McLehotsky/poit_peltier_project/documentation/Obrazky/volaniePoziadavkyWEBstranky.png

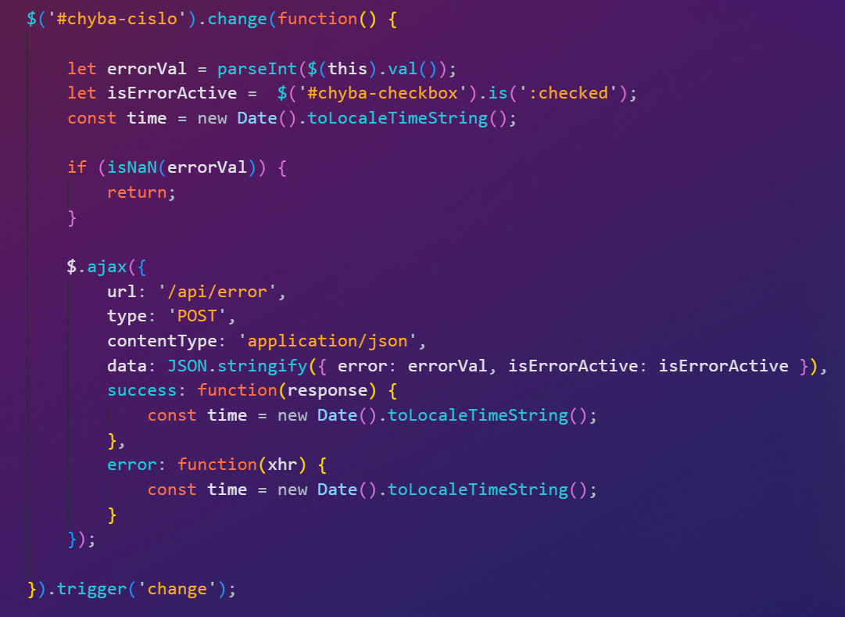
documentation/Obrazky/volaniePoziadavkyWEBstranky.png
