McLehotsky/poit_peltier_project/documentation/Obrazky/dashboard1.png

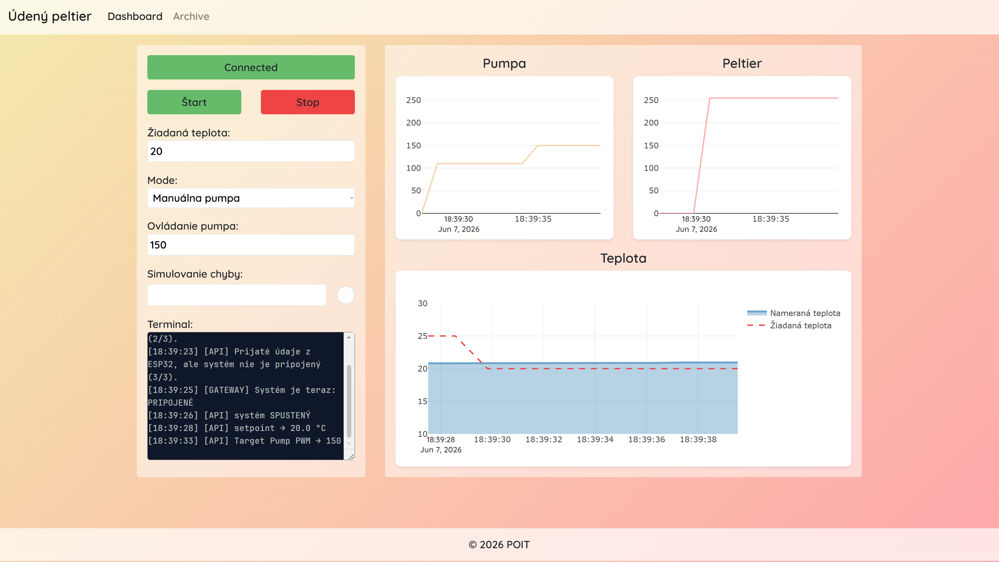
documentation/Obrazky/dashboard1.png
