McLehotsky/poit_peltier_project/documentation/Kapitoly/Kapitola5.tex

% !TEX root = ../main.tex

\section{Softvérová časť}

Softvérová časť projektu zabezpečuje prepojenie medzi hardvérovým modelom, 
lokálnym webovým rozhraním, databázou a cloudovou platformou ThingsBoard. 
Hlavnou úlohou softvéru je prijímať dáta z mikrokontroléra ESP32, 
spracovať aktuálny stav systému, zobraziť namerané hodnoty v reálnom čase, 
ukladať historické merania a umožniť lokálne aj vzdialené ovládanie systému.

Základný tok dát je navrhnutý tak, že ESP32 periodicky odosiela aktuálne hodnoty na 
Flask server. Server prijaté dáta spracuje, odošle ich do lokálneho webového dashboardu 
pomocou WebSocket komunikácie, pri aktívnom meraní ich uloží do dočasného buffra 
a zároveň publikuje telemetriu do platformy ThingsBoard. Po zastavení merania 
sa celá meracia sekvencia uloží do MySQL databázy a do záložného JSON súboru.

\begin{figure}[H]
    \centering
    \safeimage{obrazky/tok_dat.png}{0.90\textwidth}{Diagram toku dát softvérovej časti systému}
    \label{fig:tok_dat_softver}
\end{figure}

\subsection{Architektúra softvérového riešenia}

Softvérové riešenie je sústredené okolo Flask servera, ktorý prepája ESP32, webové rozhranie, databázu a platformu ThingsBoard. ESP32 zabezpečuje meranie a výkonové riadenie, zatiaľ čo server spracúva prijaté dáta, uchováva aktuálny stav systému a poskytuje rozhrania pre lokálne aj vzdialené ovládanie.

Hlavné softvérové časti sú:

\begin{itemize}
    \item \textbf{ESP32 firmvér} -- odosielanie nameraných hodnôt a prijímanie riadiacich parametrov,
    \item \textbf{Flask server} -- REST API, WebSocket komunikácia, stav systému a ukladanie dát,
    \item \textbf{webové rozhranie} -- realtime grafy, ovládacie prvky a archív meraní,
    \item \textbf{ThingsBoard integrácia} -- MQTT telemetria a vybrané vzdialené príkazy.
\end{itemize}

\subsection{Komunikácia ESP32 so serverom}

Mikrokontrolér ESP32 odosiela namerané údaje na Flask server pomocou HTTP požiadavky 
na endpoint \path{/api/update}. Odosielaná správa obsahuje aktuálnu teplotu kvapaliny, 
PWM hodnotu pumpy a PWM hodnotu Peltierovho článku.

\begin{lstlisting}[language=json, caption={Príklad dát odosielaných z ESP32 na server}]
{
  "temperature": 24.5,
  "pump_pwm": 150,
  "tec_pwm": 120
}
\end{lstlisting}

Server po prijatí dát aktualizuje svoj interný stav a odošle ESP32 spätnú odpoveď. 
Tá obsahuje napríklad informáciu o tom, či je systém pripojený, či beží meranie, 
aký režim riadenia je zvolený, aké sú cieľové PWM hodnoty a aká je nastavená požadovaná teplota.

\begin{lstlisting}[language=json, caption={Príklad odpovede servera pre ESP32}]
{
  "status": "ok",
  "connected": true,
  "running": true,
  "mode": 1,
  "target_pump": 150,
  "target_tec": 120,
  "setpoint": 25.0
}
\end{lstlisting}

Dôležitým prvkom je stav \path{connected}. Ak server vráti hodnotu \path{connected=false}, 
hardvér ostáva v bezpečnom stave a výkonové prvky nemusia byť aktivované. Tým sa zabraňuje 
nechcenému spusteniu Peltierovho článku alebo pumpy.

\subsection{Backend Flask server a REST API}

Flask server tvorí centrálny bod softvérovej časti. Prijíma dáta z ESP32, uchováva 
aktuálny stav systému, spracúva príkazy z webového rozhrania, komunikuje s ThingsBoardom a 
zabezpečuje ukladanie meraní. Aktuálne hodnoty sú uložené v stavovej premennej 
\path{system_state}, ktorá obsahuje napríklad teplotu, PWM hodnoty, setpoint, režim riadenia, 
stav merania a buffer aktuálnej session.

Pre komunikáciu sú vytvorené REST API endpointy uvedené v tabuľke \ref{tab:rest_api_endpointy}.

{\small
\begin{longtable}{|>{\RaggedRight\arraybackslash}p{0.33\textwidth}|>{\centering\arraybackslash}p{0.12\textwidth}|>{\RaggedRight\arraybackslash}p{0.45\textwidth}|}
\hline
\textbf{Endpoint} & \textbf{Metóda} & \textbf{Úloha} \\
\hline
\path{/api/update} & POST & Príjem aktuálnych dát z ESP32. \\
\hline
\path{/api/connect} & POST & Logické pripojenie alebo odpojenie systému. \\
\hline
\path{/api/start} & POST & Spustenie merania alebo regulácie. \\
\hline
\path{/api/stop} & POST & Zastavenie systému a uloženie aktuálnej session. \\
\hline
\path{/api/setpoint} & POST & Nastavenie požadovanej teploty. \\
\hline
\path{/api/mode} & POST & Nastavenie režimu riadenia systému. \\
\hline
\path{/api/pwm_pump} & POST & Nastavenie cieľovej PWM hodnoty pumpy. \\
\hline
\path{/api/pwm_tec} & POST & Nastavenie cieľovej PWM hodnoty Peltierovho článku. \\
\hline
\path{/api/error} & POST & Nastavenie simulovanej chyby alebo poruchového vstupu. \\
\hline
\path{/api/read_db/<id>} & GET & Čítanie historického záznamu z databázy. \\
\hline
\path{/api/read_log/<id>} & GET & Čítanie historického záznamu zo súboru JSON. \\
\hline
\caption{Prehľad hlavných REST API endpointov}
\label{tab:rest_api_endpointy}
\end{longtable}
}

Endpoint \path{/api/update} je hlavný vstupný bod pre dáta z hardvéru. Endpointy \path{/api/start} a \path{/api/stop} riadia začiatok a koniec merania. Endpointy pre setpoint, režim riadenia a PWM hodnoty slúžia na zmenu riadiacich parametrov systému.

Na strane Flask servera sú jednotlivé endpointy definované pomocou dekorátora \path{@app.route}. 
Každý endpoint má určenú URL adresu a povolenú HTTP metódu. Po prijatí požiadavky server upraví 
príslušnú hodnotu v premennej \path{system_state}, prípadne vykoná doplnkovú akciu, napríklad 
uloženie merania alebo zápis správy do terminálu. Príklad definície endpointov pre zastavenie 
systému a nastavenie PWM hodnôt pumpy a Peltierovho článku je uvedený na obrázku 
\ref{fig:def_endpoint}.

\begin{figure}[H]
    \centering
    \safeimage{obrazky/defEndpoint.png}{0.95\textwidth}{Príklad definície REST API endpointov vo Flask serveri}
    \label{fig:def_endpoint}
\end{figure}

\subsection{Webové rozhranie a realtime prenos dát}

Lokálne webové rozhranie slúži na sledovanie aktuálneho stavu systému a na zadávanie 
riadiacich príkazov. Frontend je vytvorený pomocou HTML, CSS a JavaScriptu. 
Grafy sú vykresľované pomocou knižnice Plotly.

Realtime prenos dát medzi serverom a webovým rozhraním je realizovaný pomocou WebSocket 
komunikácie cez Flask-SocketIO. Po prijatí nových dát zo zariadenia server odošle udalosť 
\path{new_data}, ktorú frontend použije na aktualizáciu grafov.

Webové rozhranie zobrazuje:

\begin{itemize}
    \item aktuálnu teplotu kvapaliny,
    \item požadovanú teplotu,
    \item PWM hodnotu pumpy,
    \item PWM hodnotu Peltierovho článku,
    \item aktuálny stav systému a režim riadenia.
\end{itemize}

Používateľ môže cez webové rozhranie systém pripojiť, spustiť alebo zastaviť meranie, 
nastaviť požadovanú teplotu, zvoliť regulačný mód a manuálne nastaviť PWM hodnoty pumpy a 
Peltierovho článku. Manuálne nastavenie oboch PWM hodnôt je využité aj v samostatnom 
manuálnom režime, ktorý slúži na priame ovládanie pumpy a Peltierovho článku bez automatického 
regulačného zásahu. Súčasťou webovej aplikácie je aj archívna stránka, ktorá umožňuje 
zobrazenie historických meraní z databázy alebo zo súboru JSON.

Príkazy z webového rozhrania sú na server odosielané pomocou asynchrónnych HTTP požiadaviek. 
Na strane JavaScriptu sa pri zmene hodnoty vo formulári alebo po stlačení tlačidla vytvorí 
požiadavka na príslušný endpoint. Dáta sú odoslané vo formáte JSON, pričom server následne 
aktualizuje svoj interný stav a pri ďalšej komunikácii odošle nové hodnoty do ESP32. Príklad 
volania požiadavky z webového rozhrania pre nastavenie simulovanej chyby je uvedený na obrázku 
\ref{fig:volanie_poziadavky_web}.

\begin{figure}[H]
    \centering
    \safeimage{obrazky/volaniePoziadavkyWEBstranky.png}{0.95\textwidth}{Príklad volania požiadavky z webového rozhrania}
    \label{fig:volanie_poziadavky_web}
\end{figure}

Návrh lokálneho webového rozhrania bol pred samotnou implementáciou pripravený vo Figme. 
Cieľom návrhu bolo rozdeliť aplikáciu na dve hlavné časti -- aktuálny dashboard a archív 
meraní. Dashboard bol navrhnutý ako hlavná obrazovka pre ovládanie systému, zobrazovanie 
aktuálnych grafov a sledovanie diagnostických informácií. Archívna časť bola navrhnutá 
na výber zdroja dát a zobrazenie historických záznamov z databázy alebo zo súboru JSON.

\begin{figure}[H]
    \centering
    \safeimage{obrazky/figma1.jpg}{0.90\textwidth}{Návrh hlavného dashboardu vo Figme}
    \label{fig:figma_dashboard}
\end{figure}

\begin{figure}[H]
    \centering
    \safeimage{obrazky/figma2.jpg}{0.90\textwidth}{Návrh archívnej obrazovky vo Figme}
    \label{fig:figma_archiv}
\end{figure}

Pri implementácii bol návrh upravený do webovej aplikácie zobrazenej v prehliadači. 
Hlavný dashboard obsahuje tlačidlá na pripojenie systému, spustenie a zastavenie merania, 
nastavenie požadovanej teploty, výber režimu riadenia, manuálne zadanie PWM hodnoty pumpy 
a diagnostický terminál. Pravá časť obrazovky slúži na zobrazenie grafov PWM pumpy, 
PWM Peltierovho článku a aktuálnej teploty kvapaliny.

\begin{figure}[H]
    \centering
    \safeimage{obrazky/dashboard1.png}{0.95\textwidth}{Implementované lokálne webové rozhranie -- dashboard}
    \label{fig:web_dashboard}
\end{figure}

Archívna obrazovka umožňuje zvoliť zdroj dát, zadať index záznamu a následne zobraziť 
uložené historické priebehy. Zobrazované sú samostatné grafy pre PWM pumpy, PWM Peltierovho 
článku a teplotu. Takéto rozdelenie uľahčuje spätné vyhodnotenie merania a kontrolu priebehu 
akčných zásahov.

\begin{figure}[H]
    \centering
    \safeimage{obrazky/dashboard2.png}{0.95\textwidth}{Implementované lokálne webové rozhranie -- archív meraní}
    \label{fig:web_archiv}
\end{figure}

\subsection{Dátová vrstva -- MySQL a JSON}

Dátová vrstva je navrhnutá ako dvojúrovňové ukladanie nameraných údajov. 
Počas aktívneho merania sa dáta ukladajú do dočasného buffra \path{session_buffer}. 
Dátové body sa do buffra pridávajú iba vtedy, keď je systém v stave \path{running=True}. 
Tým sa zabraňuje ukladaniu zbytočných údajov v pohotovostnom režime.

Každý dátový bod obsahuje poradové číslo vzorky, časovú značku, teplotu, 
PWM hodnotu pumpy, PWM hodnotu Peltierovho článku, požadovanú teplotu a aktuálny režim riadenia.

Po zastavení merania sa celá session uloží naraz do dvoch úložísk:

\begin{itemize}
    \item do MySQL databázy \path{ml_poit}, tabuľka \path{graph},
    \item do lokálneho súboru \path{data_log.json}.
\end{itemize}

Databáza slúži ako hlavné úložisko historických meraní. JSON súbor slúži ako 
jednoduchá záloha a umožňuje čítanie dát aj bez databázového servera. 
Po úspešnom uložení sa buffer vyčistí a systém je pripravený na ďalšie meranie.

Ukladanie do databázy bolo overené pomocou nástroja phpMyAdmin. V databáze sa nachádza 
tabuľka \path{graph}, v ktorej je každá meracia session uložená ako samostatný záznam. 
Stĺpec \path{hodnoty} obsahuje priebeh merania vo forme JSON reťazca a stĺpec 
\path{created_at} uchováva čas vytvorenia záznamu.

\begin{figure}[H]
    \centering
    \safeimage{obrazky/Databaza.png}{0.95\textwidth}{Uložené meracie záznamy v MySQL databáze zobrazené cez phpMyAdmin}
    \label{fig:databaza_mysql}
\end{figure}

Paralelne s databázovým zápisom sa merania ukladajú aj do súboru \path{data_log.json}. 
Každý riadok súboru predstavuje jednu meraciu session a obsahuje postupnosť dátových bodov. 
Dátový bod obsahuje poradové číslo vzorky, časovú značku, nameranú teplotu, PWM hodnotu pumpy, 
PWM hodnotu Peltierovho článku, požadovanú teplotu a aktuálny režim systému.

\begin{figure}[H]
    \centering
    \safeimage{obrazky/JSON.png}{0.95\textwidth}{Záložné ukladanie meraní do súboru data\_log.json}
    \label{fig:json_log}
\end{figure}

\subsection{ThingsBoard integrácia}

Pre vzdialený monitoring a manažment systému bola použitá platforma ThingsBoard. 
Flask server komunikuje s ThingsBoardom pomocou MQTT protokolu na porte 
\path{1883} s autentifikáciou pomocou prístupového tokenu zariadenia. 

MQTT klient beží asynchrónne v separátnom vlákne (\texttt{loop\_start()}), čím neblokuje hlavnú Flask aplikáciu. Konfigurácia pripojenia je definovaná nasledovne:

\begin{verbatim}
TB_HOST  = "thingsboard.cloud"
TB_PORT  = 1883
TB_TOKEN = <device_access_token>
\end{verbatim}

Po prijatí dát z ESP32 server publikuje telemetriu na topic 
\path{v1/devices/me/telemetry}.

Pripojenie k ThingsBoardu je v backendovej časti aplikácie definované pomocou parametrov 
\path{TB_HOST}, \path{TB_PORT} a \path{TB_TOKEN}. Parameter \path{TB_HOST} určuje adresu 
ThingsBoard servera, parameter \path{TB_PORT} určuje port MQTT komunikácie a parameter 
\path{TB_TOKEN} predstavuje prístupový token zariadenia vytvoreného v ThingsBoarde. 
V projekte bola použitá cloudová inštancia \path{thingsboard.cloud} a MQTT port \path{1883}.

\begin{lstlisting}[caption={Základné nastavenie pripojenia k ThingsBoardu}]
TB_HOST = "thingsboard.cloud"
TB_PORT = 1883
TB_TOKEN = "<device_access_token>"
\end{lstlisting}

MQTT klient beží asynchrónne v samostatnom vlákne, aby neblokoval hlavnú Flask aplikáciu. 
Server tak môže súčasne prijímať dáta z ESP32, obsluhovať lokálne webové rozhranie a odosielať 
telemetriu do cloudovej platformy.

Do ThingsBoardu sa odosielajú hlavné veličiny uvedené v tabuľke \ref{tab:thingsboard_telemetria}.

{\small
\begin{longtable}{|>{\RaggedRight\arraybackslash}p{0.26\textwidth}|>{\RaggedRight\arraybackslash}p{0.48\textwidth}|>{\RaggedRight\arraybackslash}p{0.16\textwidth}|}
\hline
\textbf{Kľúč} & \textbf{Popis} & \textbf{Jednotka / rozsah} \\
\hline
\path{temperature} & Nameraná teplota kvapaliny. & $^\circ$C \\
\hline
\path{setpoint} & Požadovaná teplota. & $^\circ$C \\
\hline
\path{error} & Regulačná odchýlka. & $^\circ$C \\
\hline
\path{pump_pwm} & PWM hodnota pumpy. & 0--255 \\
\hline
\path{tec_pwm} & PWM hodnota Peltierovho článku. & 0--255 \\
\hline
\path{mode} & Aktívny režim systému. & 1 / 2 / 3 / 4 \\
\hline
\path{running} & Stav regulácie. & bool \\
\hline
\caption{Telemetrické veličiny odosielané do ThingsBoardu}
\label{tab:thingsboard_telemetria}
\end{longtable}
}

Okrem číselných hodnôt sa do ThingsBoardu odosiela aj textový atribút \path{terminal}, 
ktorý zobrazuje stručný diagnostický stav systému. 

Dashboard v ThingsBoarde je rozdelený na dva stavy. 

V prostredí ThingsBoard bol vytvorený dashboard \textit{Peltier Control System}. Dashboard je 
rozdelený na dva hlavné stavy: \textit{Default} a \textit{Archív}. Stav \textit{Default} slúži 
na sledovanie a ovládanie systému v reálnom čase. Obsahuje grafy teploty, PWM pumpy a PWM 
Peltierovho článku, ovládacie tlačidlá, prepínanie módov, vstupy pre manuálne PWM hodnoty 
a diagnostické widgety. Stav \textit{Archív} slúži na zobrazenie historických údajov za posledných 
24 hodín.

Vizualizačné widgety v stave \textit{Default} sú naviazané na telemetrické kľúče odosielané 
z Flask servera. Graf teploty zobrazuje hodnoty \path{temperature} a \path{setpoint} 
v časovom okne 300~s. Graf pumpy zobrazuje hodnotu \path{pump_pwm} v časovom 
okne 60~s a graf Peltierovho článku zobrazuje hodnotu \path{tec_pwm} taktiež v 
časovom okne 60~s. Aktualizácia grafov je nastavená na 1~s.

{\small
\begin{longtable}{|>{\RaggedRight\arraybackslash}p{0.30\textwidth}|>{\RaggedRight\arraybackslash}p{0.28\textwidth}|>{\RaggedRight\arraybackslash}p{0.18\textwidth}|>{\RaggedRight\arraybackslash}p{0.14\textwidth}|}
\hline
\textbf{Widget} & \textbf{Sledovaná veličina} & \textbf{Časové okno} & \textbf{Aktualizácia} \\
\hline
Teplota [C$^\circ$] (\path{w_teplota}) & \path{temperature}, \path{setpoint} & 300~s & 1~s \\
\hline
Pumpa (\path{w_pumpa}) & \path{pump_pwm} & 60~s & 1~s \\
\hline
PET (\path{w_pet}) & \path{tec_pwm} & 60~s & 1~s \\
\hline
\caption{Vizualizačné widgety v stave Default}
\label{tab:tb_default_widgety}
\end{longtable}
}

Ovládacie tlačidlá \textit{Connect}, \textit{Start} a \textit{Stop} odosielajú RPC príkazy, ktoré 
Flask server spracuje a premietne do aktuálneho stavu systému. Tlačidlá \textit{Mod 1}, 
\textit{Mod 2}, \textit{Mod 3} a \textit{Mod 4} nastavujú režim systému zápisom zdieľaného atribútu 
\path{control_mode}. Prvé tri módy predstavujú regulačné režimy podľa zadania, pričom doplnený 
štvrtý mód predstavuje manuálne riadenie pumpy aj Peltierovho článku.

{\small
\begin{longtable}{|>{\RaggedRight\arraybackslash}p{0.30\textwidth}|>{\RaggedRight\arraybackslash}p{0.35\textwidth}|>{\centering\arraybackslash}p{0.20\textwidth}|}
\hline
\textbf{Widget} & \textbf{Zdieľaný atribút / metóda} & \textbf{Hodnota} \\
\hline
Connect (\path{w_connect}) & \path{setConnected} & \path{true} \\
\hline
Start (\path{w_start}) & \path{setRunning} & \path{true} \\
\hline
Stop (\path{w_stop}) & \path{setRunning} & \path{false} \\
\hline
Mod 1 (\path{w_mod1}) & \path{control_mode} & 1 \\
\hline
Mod 2 (\path{w_mod2}) & \path{control_mode} & 2 \\
\hline
Mod 3 (\path{w_mod3}) & \path{control_mode} & 3 \\
\hline
Mod 4 (\path{w_mod4}) & \path{control_mode} & 4 \\
\hline
\caption{Ovládacie widgety v ThingsBoard dashboarde}
\label{tab:tb_ovladacie_widgety}
\end{longtable}
}

Vstupné polia pre manuálne PWM hodnoty umožňujú nastaviť výkon pumpy a Peltierovho článku. 
Hodnoty sa zapisujú do zdieľaných atribútov zariadenia a Flask server ich prijíma cez MQTT komunikáciu.

{\small
\begin{longtable}{|>{\RaggedRight\arraybackslash}p{0.34\textwidth}|>{\RaggedRight\arraybackslash}p{0.34\textwidth}|>{\RaggedRight\arraybackslash}p{0.12\textwidth}|>{\RaggedRight\arraybackslash}p{0.12\textwidth}|}
\hline
\textbf{Widget} & \textbf{Zdieľaný atribút} & \textbf{Typ} & \textbf{Rozsah} \\
\hline
Ovládanie: Pump PWM (\path{w_pump_ctrl}) & \path{target_pump_pwm} & integer & 0--255 \\
\hline
Ovládanie: TEC PWM (\path{w_tec_ctrl}) & \path{target_tec_pwm} & integer & 0--255 \\
\hline
\caption{Manuálne nastavenie PWM hodnôt cez ThingsBoard}
\label{tab:tb_pwm_vstupy}
\end{longtable}
}

Diagnostický widget \textit{Error} (\path{w_error}) zobrazuje aktuálnu regulačnú odchýlku ako 
hodnotu z telemetrie. Widget \textit{Terminal} (\path{w_terminal}) zobrazuje diagnostický reťazec 
\path{terminal}, ktorý je serverom aktualizovaný pri každom odoslaní telemetrie. Diagnostický 
reťazec má formát:

\begin{center}
\texttt{T=XX.X$^\circ$C\ | \ Err=X.XX\ | \ RUN/STOP\ | \ Mode=X}
\end{center}

Stav \textit{Archív} obsahuje historické grafy pre teplotu, PWM pumpy a PWM Peltierovho článku. 
Grafy pracujú s časovým oknom posledných 24 hodín.

{\small
\begin{longtable}{|>{\RaggedRight\arraybackslash}p{0.34\textwidth}|>{\RaggedRight\arraybackslash}p{0.34\textwidth}|>{\RaggedRight\arraybackslash}p{0.22\textwidth}|}
\hline
\textbf{Widget} & \textbf{Sledovaná veličina} & \textbf{Časové okno} \\
\hline
Teplota [C$^\circ$] (\path{a_teplota}) & \path{temperature}, \path{setpoint} & posledných 24 hodín \\
\hline
Pumpa (\path{a_pumpa}) & \path{pump_pwm} & posledných 24 hodín \\
\hline
PET (\path{a_pet}) & \path{tec_pwm} & posledných 24 hodín \\
\hline
\caption{Widgety v stave Archív}
\label{tab:tb_archiv_widgety}
\end{longtable}
}

\begin{figure}[H]
    \centering
    \safeimage{obrazky/thingsboard_default1.0.png}{0.95\textwidth}{ThingsBoard dashboard v stave Default}
    \label{fig:thingsboard_default}
\end{figure}

Stav \textit{Archív} slúži na zobrazenie historických dát s časovým oknom 1 deň.

\begin{table}[H]
\centering
\begin{tabular}{lll}
\toprule
\textbf{Widget (ID)} & \textbf{Sledovaná veličina} & \textbf{Časové okno} \\
\midrule
Teplota [C°] (\texttt{a\_teplota}) & \texttt{temperature}, \texttt{setpoint} & Posledných 24 hodín \\
Pumpa (\texttt{a\_pumpa})          & \texttt{pump\_pwm}                     & Posledných 24 hodín \\
PET (\texttt{a\_pet})              & \texttt{tec\_pwm}                      & Posledných 24 hodín \\
\bottomrule
\end{tabular}
\caption{Archívne widgety}
\end{table}

Stránka archívu umožňuje prezerať uložené záznamy meraní. 
Widget \texttt{a\_filter} v ThingsBoard dashboarde obsahuje tri ovládacie prvky:

TU DOPLNIT ESTE!!!!!!

\begin{figure}[H]
    \centering
    \safeimage{obrazky/thingsboard_archiv1.0.png}{0.95\textwidth}{ThingsBoard dashboard v stave Archív}
    \label{fig:thingsboard_archiv}
\end{figure}

\subsection{Obojsmerná komunikácia s ThingsBoardom}

Systém neodosiela do ThingsBoardu iba telemetriu, ale zároveň prijíma aj vybrané riadiace 
príkazy. Použité sú dva mechanizmy. Prvým sú RPC príkazy cez topic 
\path{v1/devices/me/rpc/request/+}, ktoré sa používajú hlavne pre tlačidlá 
\textit{Connect}, \textit{Start} a \textit{Stop}. Druhým mechanizmom sú zdieľané atribúty cez 
topic \path{v1/devices/me/attributes}.

Po prijatí RPC príkazu server aktualizuje svoj lokálny stav a odošle späť potvrdzujúcu odpoveď.

\begin{lstlisting}[caption={Príklad odpovede na RPC príkaz z ThingsBoardu}]
mqtt_client.publish(
    topic = "v1/devices/me/rpc/response/{request_id}",
    payload = json.dumps({"status": "ok"})
)
\end{lstlisting}

Cez zdieľané atribúty sa prenášajú najmä:

\begin{itemize}
    \item \path{control_mode} -- nastavenie režimu systému,
    \item \path{target_pump_pwm} -- cieľová PWM hodnota pumpy,
    \item \path{target_tec_pwm} -- cieľová PWM hodnota Peltierovho článku.
\end{itemize}

Po každom pripojení si server môže aktívne vyžiadať aktuálne hodnoty zdieľaných atribútov, aby 
sa predišlo desynchronizácii po reštarte aplikácie.

\begin{lstlisting}[caption={Vyžiadanie aktuálnych zdieľaných atribútov}]
client.publish(
    "v1/devices/me/attributes/request/1",
    json.dumps({"sharedKeys": "control_mode,target_pump_pwm,target_tec_pwm"})
)
\end{lstlisting}

Po prijatí zmeny z ThingsBoardu Flask server aktualizuje svoj interný stav a pri 
najbližšej komunikácii odošle nové hodnoty do ESP32. Zmeny môžu byť zároveň odoslané 
aj do lokálneho webového dashboardu pomocou WebSocket udalosti \path{status_update}.

\subsection{Režimy riadenia systému}

Systém podporuje tri regulačné módy požadované zadaním, ktoré je možné prepínať z webového 
rozhrania alebo z ThingsBoard dashboardu. Okrem týchto režimov bol doplnený aj štvrtý 
manuálny režim, ktorý slúži na priame nastavenie PWM hodnoty pumpy a Peltierovho článku.

\begin{itemize}
    \item \textbf{Mód 1} -- regulácia pomocou Peltierovho článku pri konštantnom alebo manuálne nastavenom výkone pumpy,
    \item \textbf{Mód 2} -- regulácia pomocou prietoku pumpy pri konštantnom výkone Peltierovho článku,
    \item \textbf{Mód 3} -- hybridná alebo kaskádová regulácia pomocou Peltierovho článku aj pumpy,
    \item \textbf{Mód 4} -- manuálny režim, v ktorom používateľ nastavuje PWM hodnotu pumpy aj PWM hodnotu Peltierovho článku bez automatického regulačného zásahu.
\end{itemize}

Zvolený režim sa ukladá do interného stavu servera a následne sa prenáša do ESP32. 
Pre PID reguláciu je v projekte pripravený modul \path{pid_logic.py}, ktorý obsahuje triedu 
\path{PIDController}. Finálne nastavenie regulačných parametrov závisí od výsledkov 
identifikácie a testovania reálnej tepelnej sústavy. Manuálny režim je využiteľný pri 
oživovaní hardvéru, testovaní akčných členov a overovaní vplyvu PWM hodnoty pumpy a 
Peltierovho článku na teplotu kvapaliny.
