McLehotsky/poit_peltier_project/documentation/Obrazky/dashboard2.png

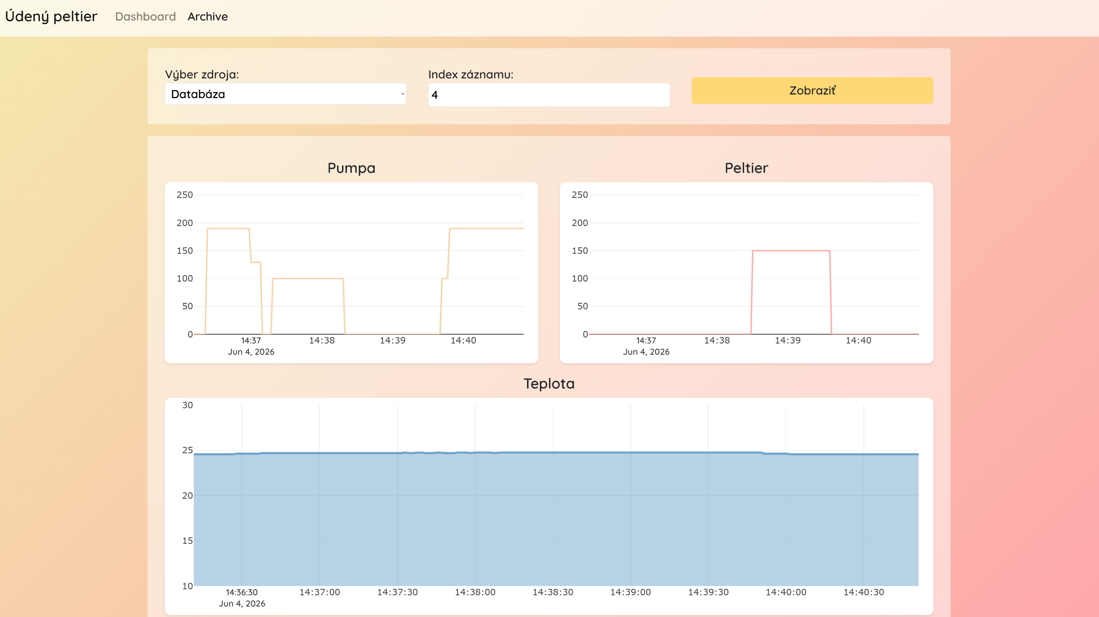
documentation/Obrazky/dashboard2.png
