McLehotsky/poit_peltier_project/documentation/Obrazky/Databaza.png

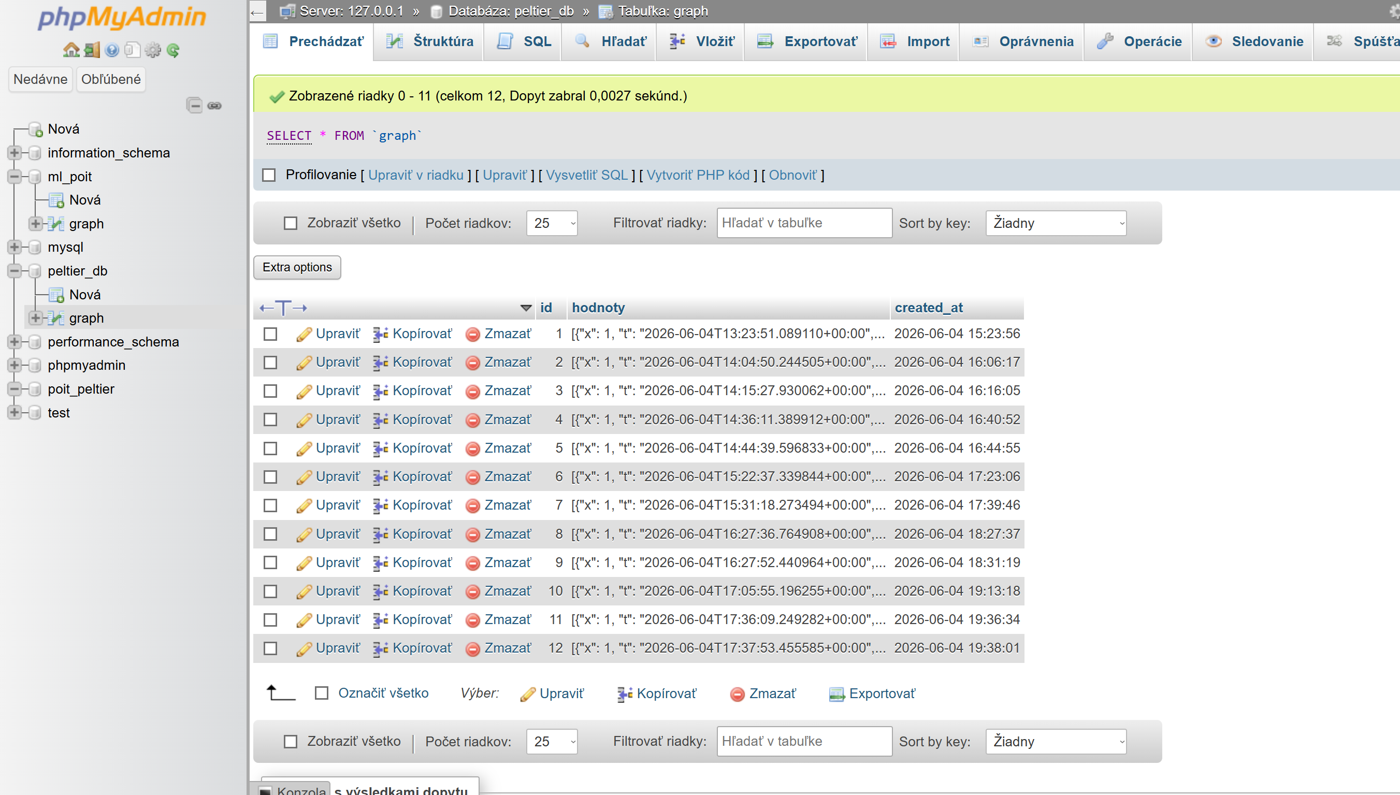
documentation/Obrazky/Databaza.png
