McLehotsky/poit_peltier_project/documentation/Obrazky/defEndpoint.png

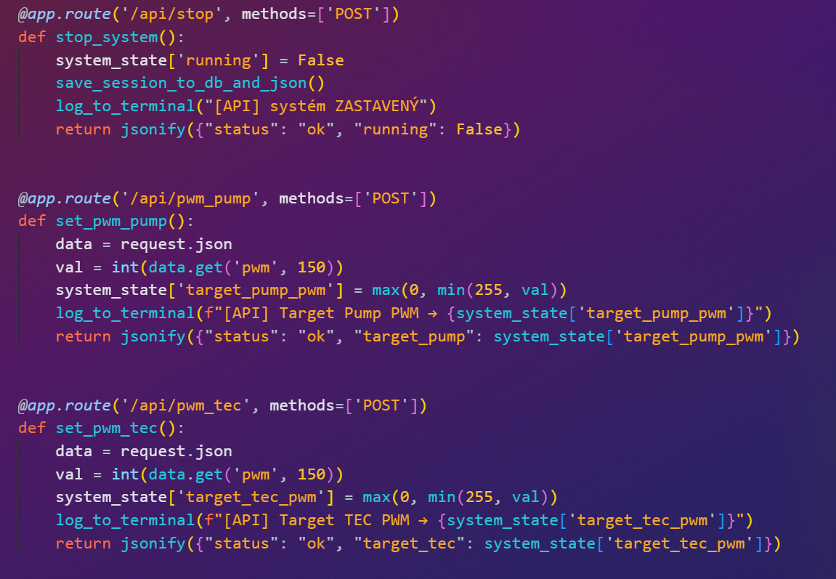
documentation/Obrazky/defEndpoint.png
