McLehotsky/poit_peltier_project/documentation/Obrazky/figma1.jpg

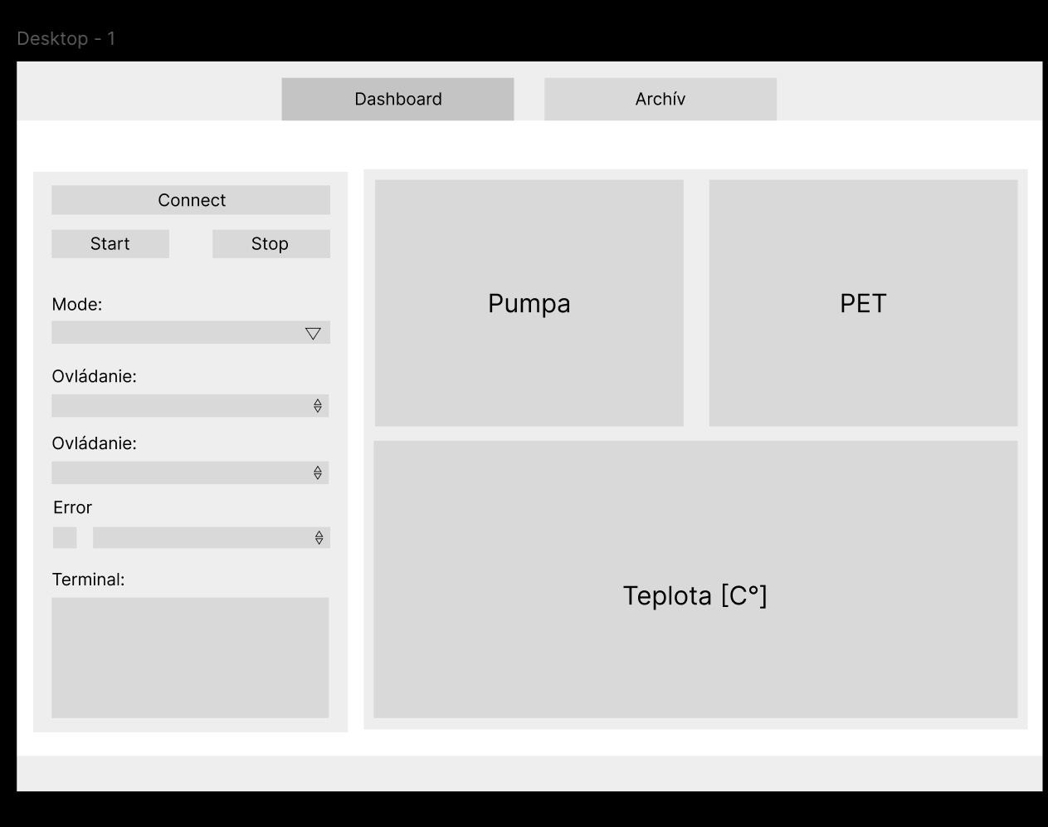
documentation/Obrazky/figma1.jpg
