McLehotsky/poit_peltier_project/documentation/Obrazky/figma2.jpg

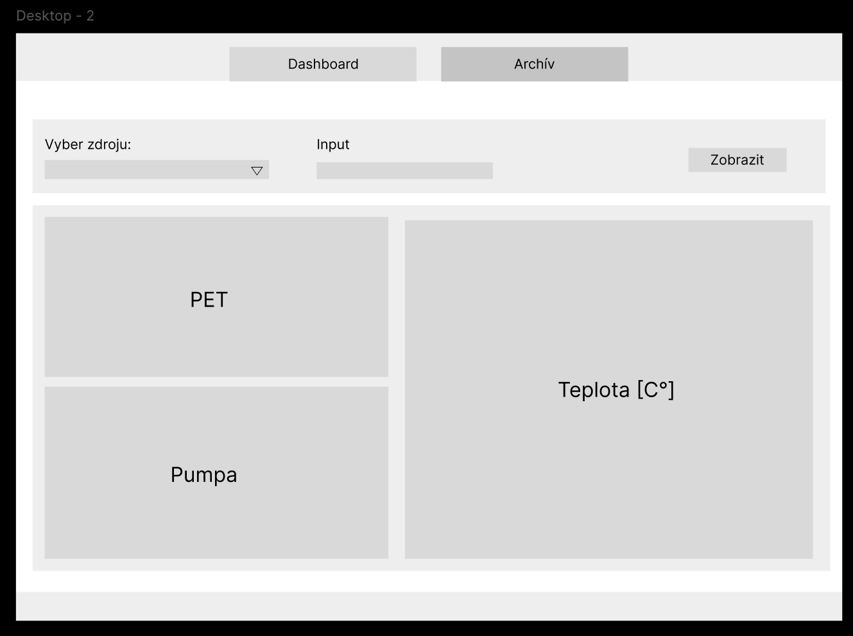
documentation/Obrazky/figma2.jpg
