McLehotsky/poit_peltier_project/documentation/Obrazky/identifikaciaPeltier.png

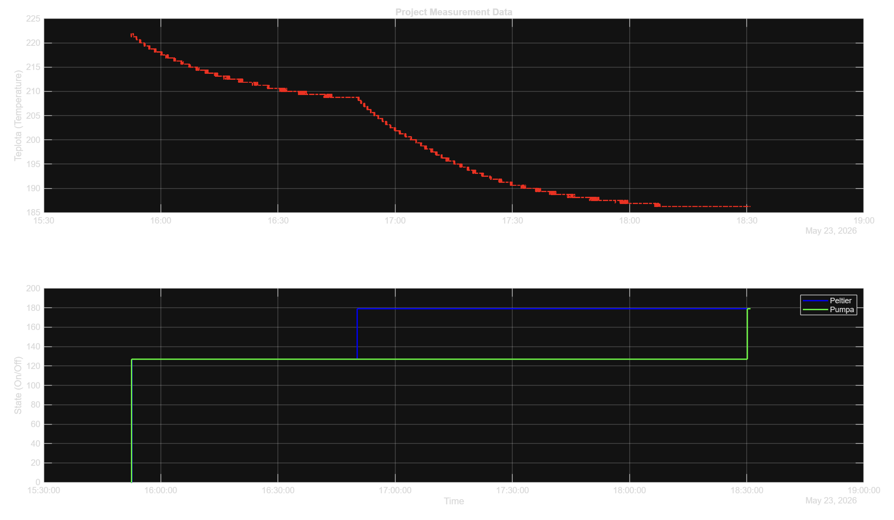
documentation/Obrazky/identifikaciaPeltier.png
