McLehotsky/poit_peltier_project/documentation/Obrazky/IdentifikaciaPumpa.png

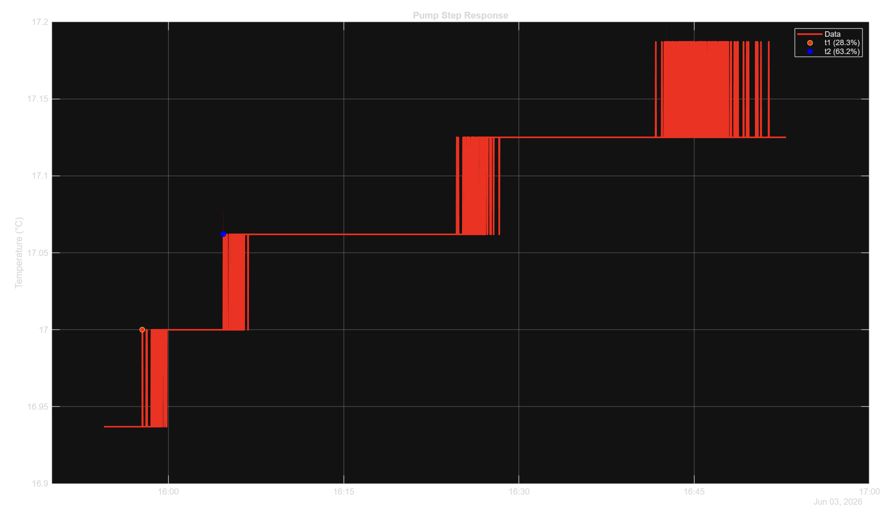
documentation/Obrazky/IdentifikaciaPumpa.png
