McLehotsky/poit_peltier_project/documentation/Obrazky/Iot_architektura.png

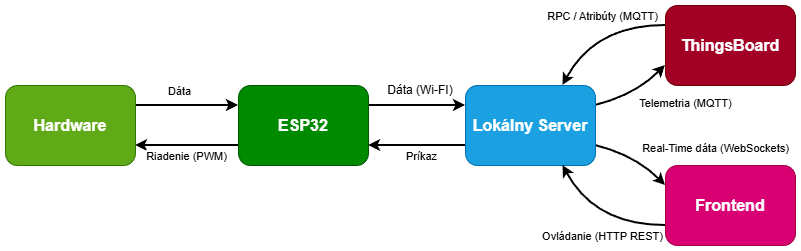
documentation/Obrazky/Iot_architektura.png
