McLehotsky/poit_peltier_project/documentation/Obrazky/JSON.png

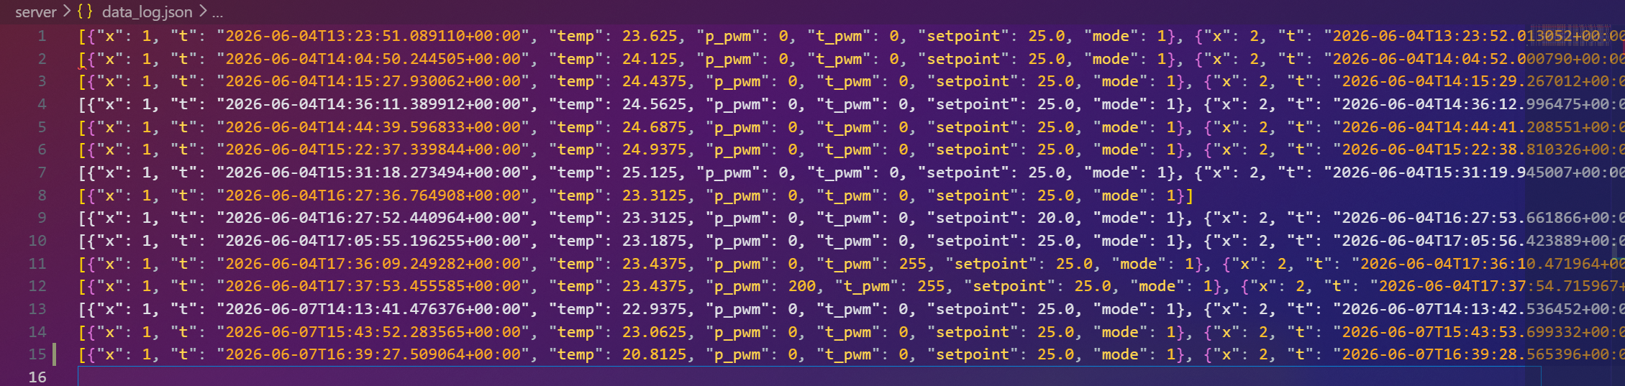
documentation/Obrazky/JSON.png
