McLehotsky/poit_peltier_project/documentation/Obrazky/plosak_spodok.png

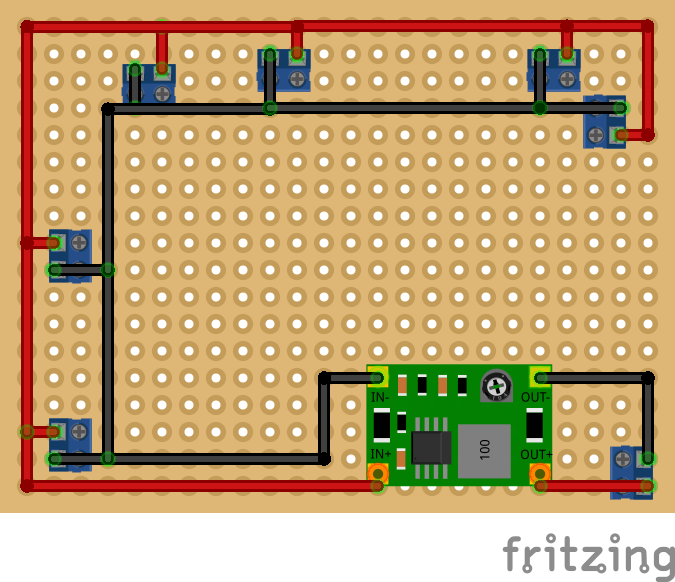
documentation/Obrazky/plosak_spodok.png
