McLehotsky/poit_peltier_project/documentation/Obrazky/Schema_zapojenia1.png

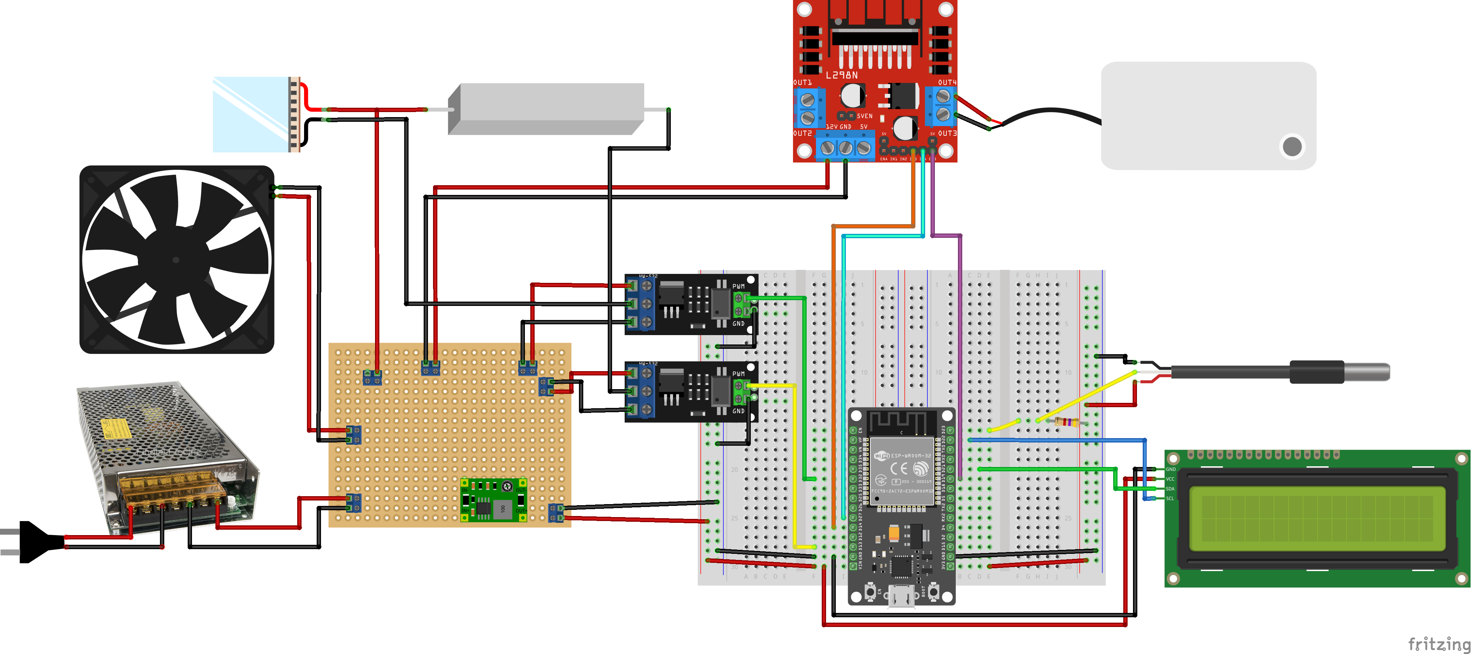
documentation/Obrazky/Schema_zapojenia1.png
