McLehotsky/poit_peltier_project/documentation/Obrazky/ThingsBoard_default1.0.png

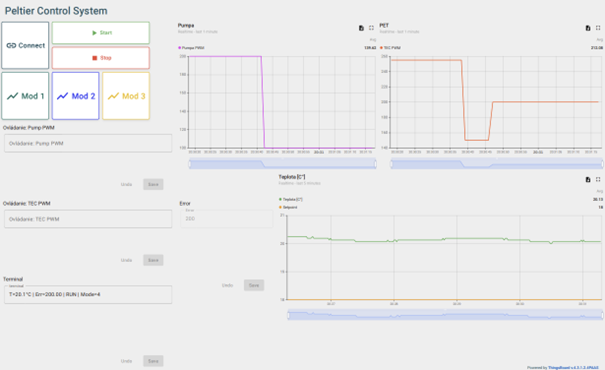
documentation/Obrazky/ThingsBoard_default1.0.png
