McLehotsky/poit_peltier_project/db_setup.txt

CREATE TABLE IF NOT EXISTS graph (
    id INT AUTO_INCREMENT PRIMARY KEY,
    hodnoty LONGTEXT,
    created_at TIMESTAMP DEFAULT CURRENT_TIMESTAMP
);
