McLehotsky/poit_peltier_project/(commit log)

2026-04-30 init app skeleton
    [config.cfg]
2026-04-30 add arduino branch
2026-06-03 add archive page and fix navigation links in templates
    [app.py]
2026-06-03 fix js methotds for buttons
2026-06-04 Implement session logging and new API endpoints for PWM control
2026-06-04 Refactor data saving to store session in both database and JSON file; update database configuration
    [config.cfg]
2026-06-04 Add mode selection and control for pump and Peltier; enhance UI elements
2026-06-04 [ADD] esp32 Wi-Fi communication with server
2026-06-04 Refactor PWM control logic to enhance error handling and user feedback in the terminal
    [app.py]
2026-06-04 Add temperature setpoint input and update temperature graph plotting
2026-06-04 updated graph, tried to fix thingsboard comunication
    [app.py]
2026-06-07 Add error handling functionality to the system
    [app.py]
2026-06-07 fix: update button color classes for connection status
2026-06-07 [ADD] ESP32 final code
2026-06-07 fix minor api conections
    [app.py]
